Spaceman113138/CADkeyboard/keyboard/keyboard.kicad_pcb

## KiCad design keyboard/keyboard.kicad_pcb (2025-06-14)

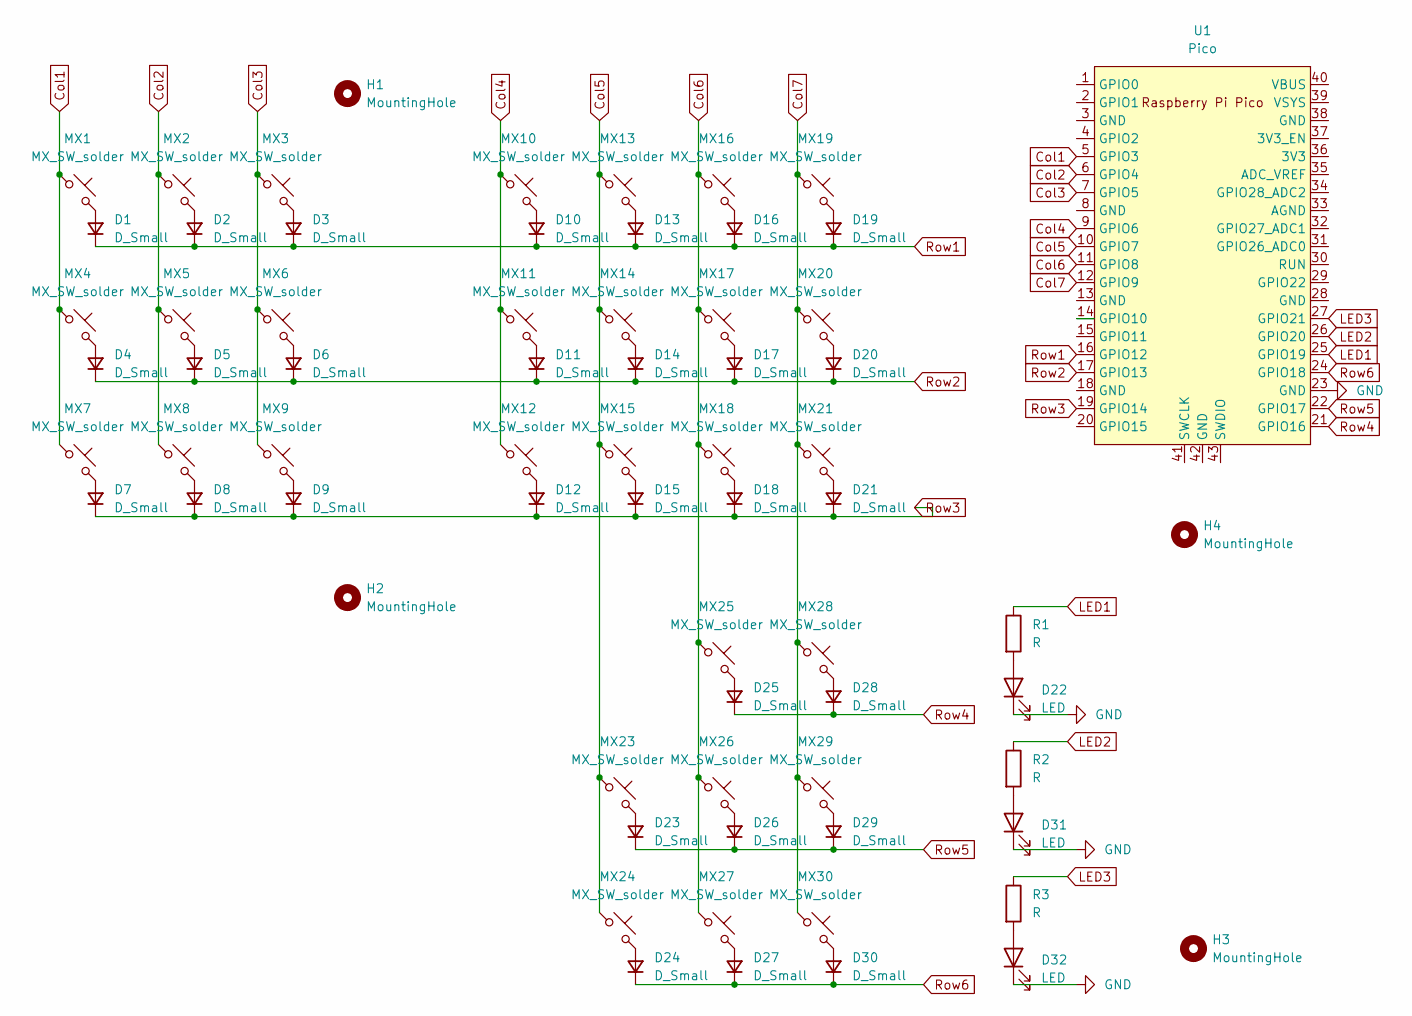
[picture p1: schematic keyboard.kicad_sch]

Parts:
D1, D2, D3, D4, D5, D6, D7, D8, D9, D10, D11, D12, D13, D14, D15, D16, D17, D18, D19, D20, D21, D23, D24, D25, D26, D27, D28, D29, D30: D_Small; D_T-1_P5.08mm_Horizontal
D22, D31, D32: LED; LED_D3.0mm
H1, H2, H3, H4: MountingHole; MountingHole_3.2mm_M3_Pad_Via
MX1, MX2, MX3, MX4, MX5, MX6, MX7, MX8, MX9, MX10, MX11, MX12, MX13, MX14, MX15, MX16, MX17, MX18, MX19, MX20, MX21, MX23, MX24, MX25, MX26, MX27, MX28, MX29, MX30: MX_SW_solder; SW_MX_1u
R1, R2, R3: R; R_Axial_DIN0204_L3.6mm_D1.6mm_P5.08mm_Horizontal
U1: Pico; RPi_Pico_SMD_TH

Connections:
Col1: MX1.1, MX4.1, MX7.1, U1.5 (GPIO3)
Col2: MX2.1, MX5.1, MX8.1, U1.6 (GPIO4)
Col3: MX3.1, MX6.1, MX9.1, U1.7 (GPIO5)
Col4: MX10.1, MX11.1, MX12.1, U1.9 (GPIO6)
Col5: MX13.1, MX14.1, MX15.1, MX23.1, MX24.1, U1.10 (GPIO7)
Col6: MX16.1, MX17.1, MX18.1, MX25.1, MX26.1, MX27.1, U1.11 (GPIO8)
Col7: MX19.1, MX20.1, MX21.1, MX28.1, MX29.1, MX30.1, U1.12 (GPIO9)
GND: D22.1 (K), D31.1 (K), D32.1 (K), U1.23 (GND)
LED1: R1.1, U1.25 (GPIO19)
LED2: R2.1, U1.26 (GPIO20)
LED3: R3.1, U1.27 (GPIO21)
unnamed: D1.2 (A), MX1.2
unnamed: D2.2 (A), MX2.2
unnamed: D3.2 (A), MX3.2
unnamed: D4.2 (A), MX4.2
unnamed: D5.2 (A), MX5.2
unnamed: D6.2 (A), MX6.2
unnamed: D7.2 (A), MX7.2
unnamed: D8.2 (A), MX8.2
unnamed: D9.2 (A), MX9.2
unnamed: D10.2 (A), MX10.2
unnamed: D11.2 (A), MX11.2
unnamed: D12.2 (A), MX12.2
unnamed: D13.2 (A), MX13.2
unnamed: D14.2 (A), MX14.2
unnamed: D15.2 (A), MX15.2
unnamed: D16.2 (A), MX16.2
unnamed: D17.2 (A), MX17.2
unnamed: D18.2 (A), MX18.2
unnamed: D19.2 (A), MX19.2
unnamed: D20.2 (A), MX20.2
unnamed: D21.2 (A), MX21.2
unnamed: D22.2 (A), R1.2
unnamed: D23.2 (A), MX23.2
unnamed: D24.2 (A), MX24.2
unnamed: D25.2 (A), MX25.2
unnamed: D26.2 (A), MX26.2
unnamed: D27.2 (A), MX27.2
unnamed: D28.2 (A), MX28.2
unnamed: D29.2 (A), MX29.2
unnamed: D30.2 (A), MX30.2
unnamed: D31.2 (A), R2.2
unnamed: D32.2 (A), R3.2
Row1: D1.1 (K), D2.1 (K), D3.1 (K), D10.1 (K), D13.1 (K), D16.1 (K), D19.1 (K), U1.16 (GPIO12)
Row2: D4.1 (K), D5.1 (K), D6.1 (K), D11.1 (K), D14.1 (K), D17.1 (K), D20.1 (K), U1.17 (GPIO13)
Row3: D7.1 (K), D8.1 (K), D9.1 (K), D12.1 (K), D15.1 (K), D18.1 (K), D21.1 (K), U1.19 (GPIO14)
Row4: D25.1 (K), D28.1 (K), U1.21 (GPIO16)
Row5: D23.1 (K), D26.1 (K), D29.1 (K), U1.22 (GPIO17)
Row6: D24.1 (K), D27.1 (K), D30.1 (K), U1.24 (GPIO18)

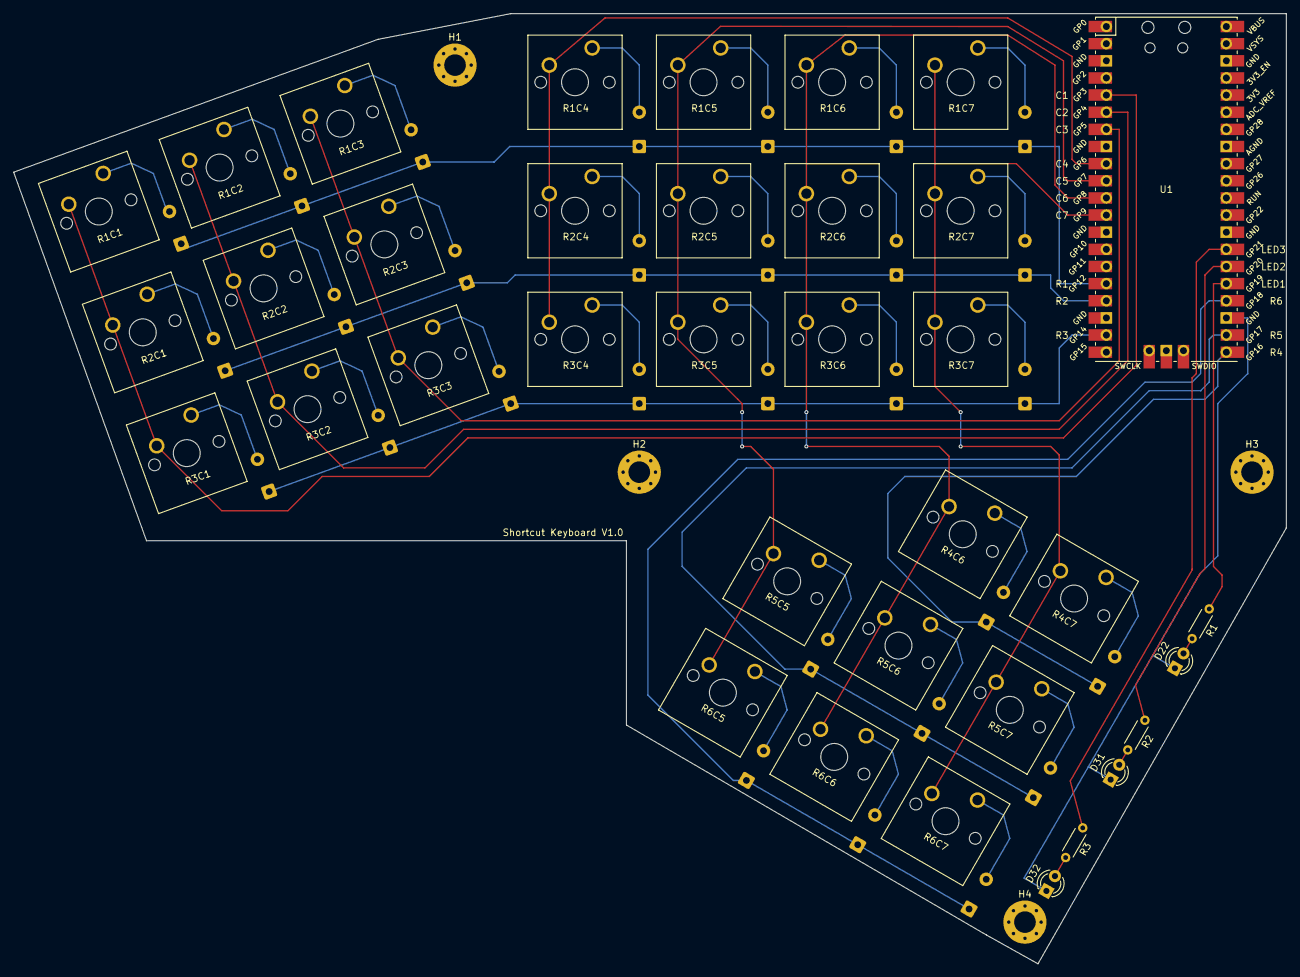
[picture p2: board keyboard.kicad_pcb from above]

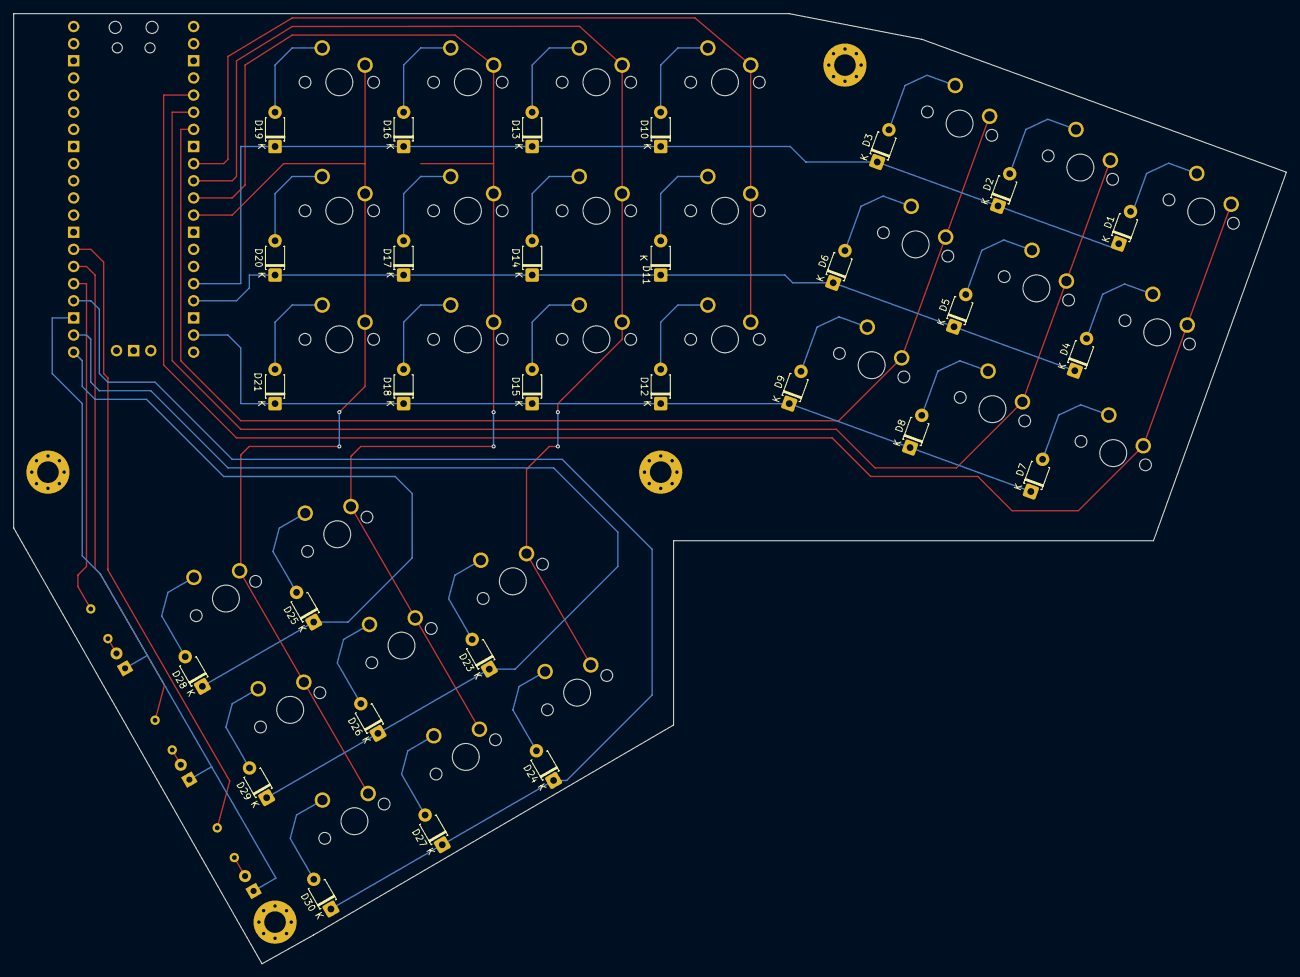
[picture p3: board keyboard.kicad_pcb from below]

Board: 2 copper layers, 188.6 x 140.8 mm, 69 parts (29 on the bottom side), 49 nets.
