Spaceman113138/CADkeyboard/IMG_4116.jpeg

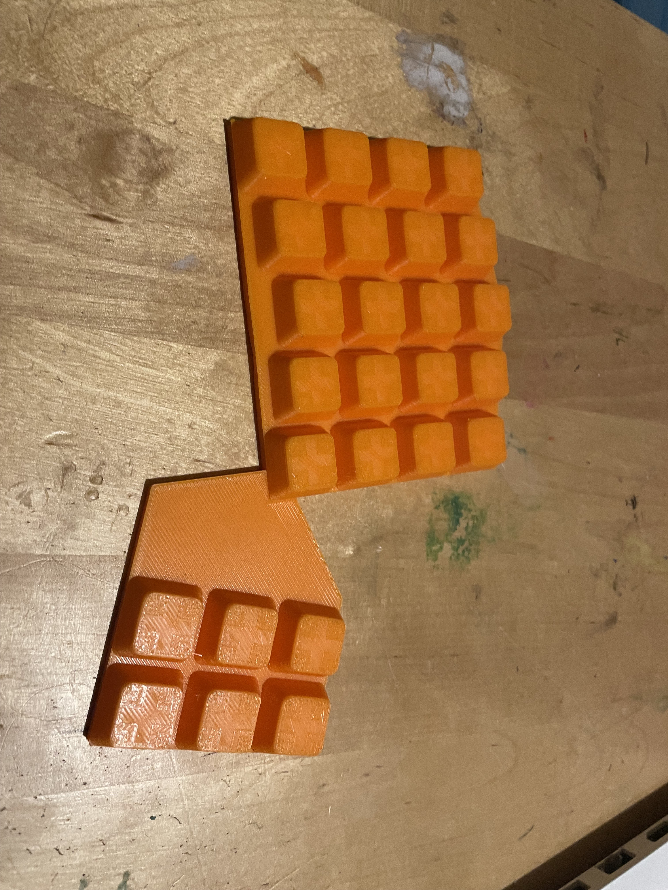
[picture p7: IMG_4116.jpeg]
IMG_4116.jpeg
