Spaceman113138/CADkeyboard/IMG_4127.jpg

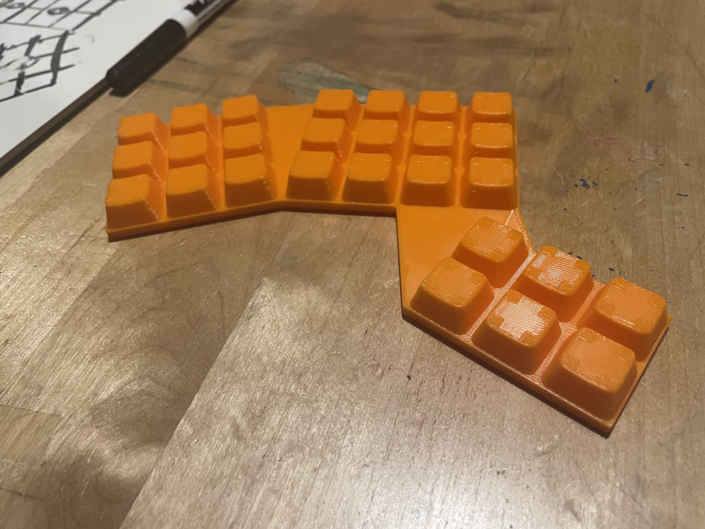
[picture p9: IMG_4127.jpg]
IMG_4127.jpg
